JimInCA/cassette-tape-emulator/images/d5-cassette-interface.jpg

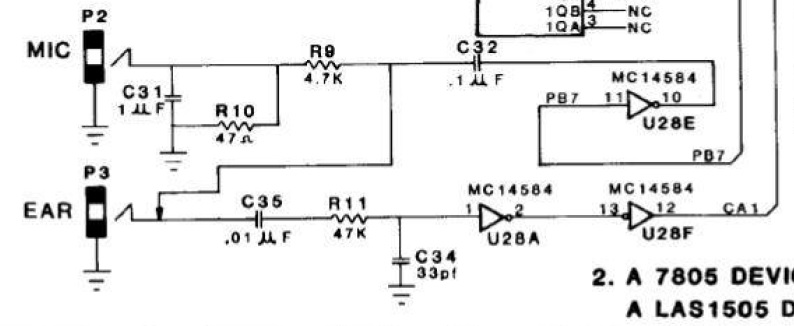
images/d5-cassette-interface.jpg
