JimInCA/cassette-tape-emulator/test-bit-boffer/README.md

Kanas City Standard Tape Drive Simulator Test Program
===
TBD
